c3polab/aurora-controller/pcb_design/ReactiveMotor_Annex_pcb.png

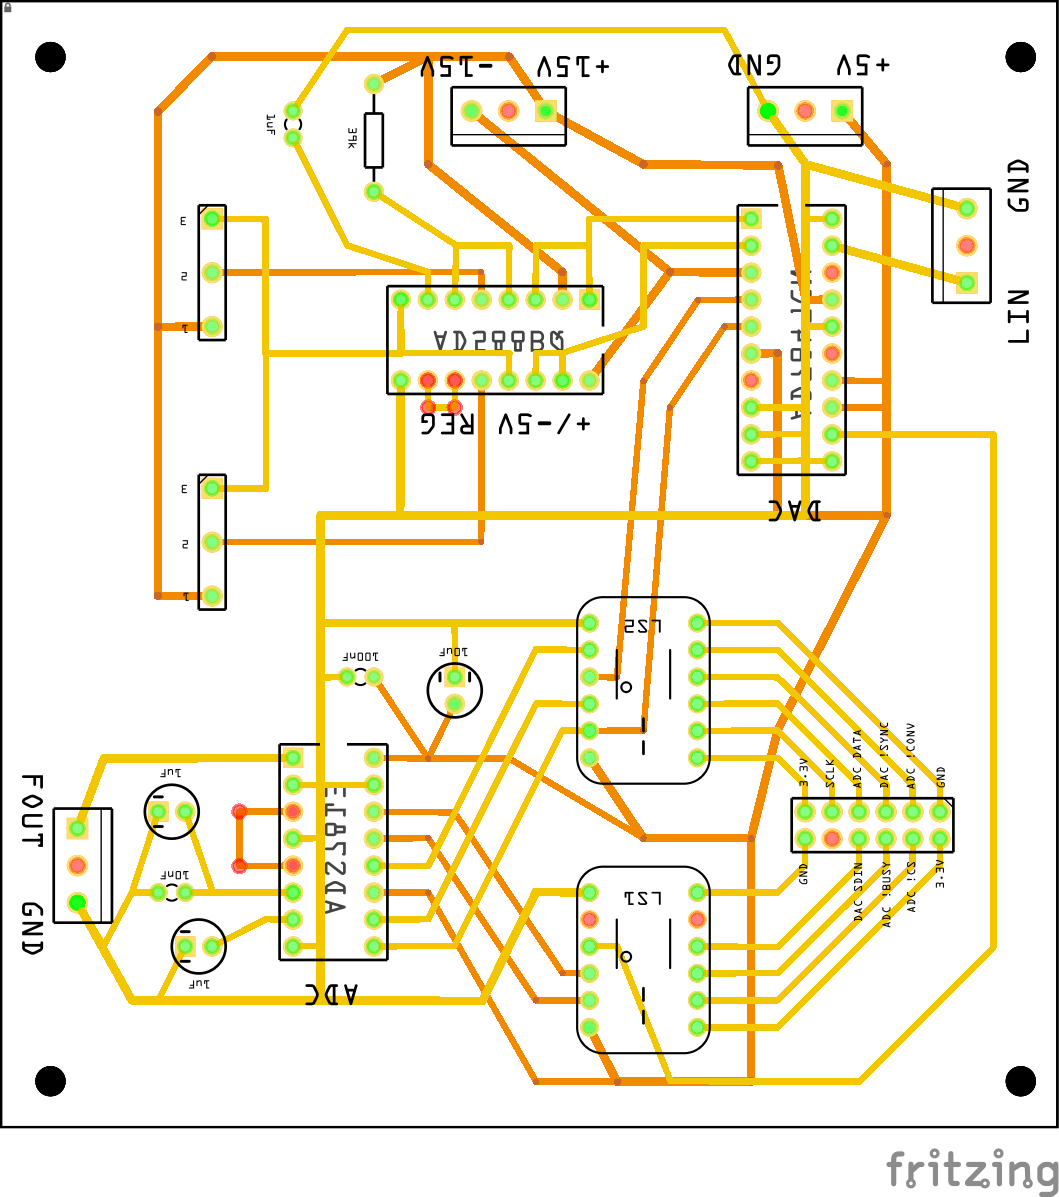
pcb_design/ReactiveMotor_Annex_pcb.png
