c3polab/aurora-controller/pcb_design/ReactiveMotor_Cape_bb.png

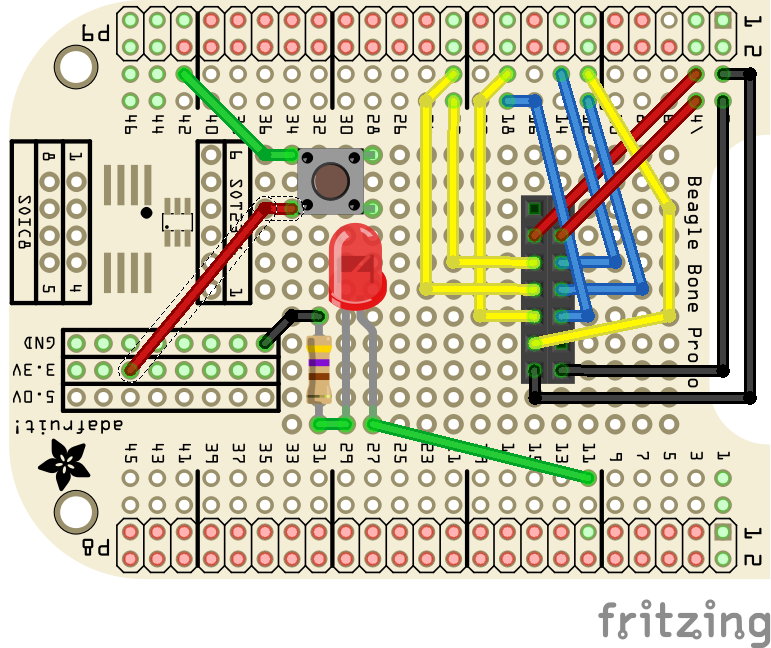
pcb_design/ReactiveMotor_Cape_bb.png
