c3polab/aurora-controller/(list of files, drawings)

Other design files:
pcb_design/ReactiveMotor_Annex.fzz
pcb_design/ReactiveMotor_Cape.fzz
