c3polab/aurora-controller/pcb_design/BeagleBone Setup.odt

Setting up the BeagleBone Black (BBB) end of reactive motor experiments:

1. Make sure BBB is plugged into a powered USB port
2. Make sure the power source is on, Caitrin.
3. Wait for the computer to recognize that it's connected to BBB
4. Use PuTTY to connect to BBB
  a. Select “BBB” in the menu
  b. Click the “Load” button to the right
  c. Click to “Open” button on the bottom
5. Now a terminal window will open, connected to the BBB. When it gives you the login prompt, type root, then ENTER.
6. Load all of the I/O bits required for reactive motor stuff by typing
      echo spi0-loop > $SLOTS
      echo ADAFRUIT-SPI0 > $SLOTS
7. If you'd like to edit the code: nano reMoRC.cpp
  save changes with CTRL+o, then ENTER exit with CTRL+x recompile with: g++ reMoRC.cpp GPIO.cpp -o reMoRC.o -pthreads
8. To run the program: ./reMoRC.o
